Gonzahart/FPV_Simulator_Car/(commit log)

2026-08-13 Add files via upload
    - added cam code
    - added tested servo code
2026-09-05 Add files via upload
    - Initial rear motor + steering motor validated
2026-10-19 Document RC car architecture and motor-control prototype
2026-10-27 Add authenticated web OTA to ESP32-CAM motor test
