Gonzahart/FPV_Simulator_Car/IMG_7815.jpeg

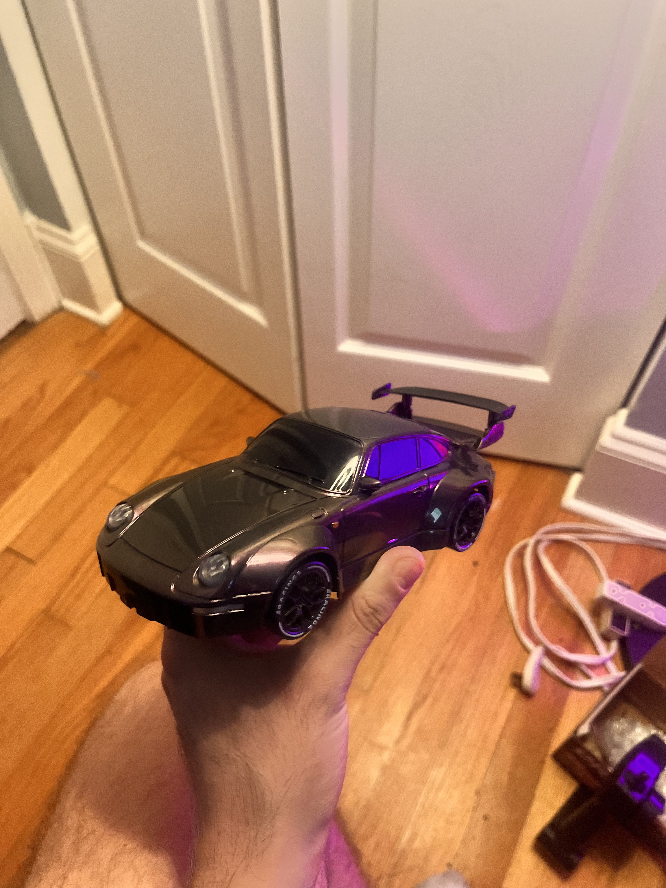
IMG_7815.jpeg
