Gonzahart/FPV_Simulator_Car/IMG_7820.jpeg

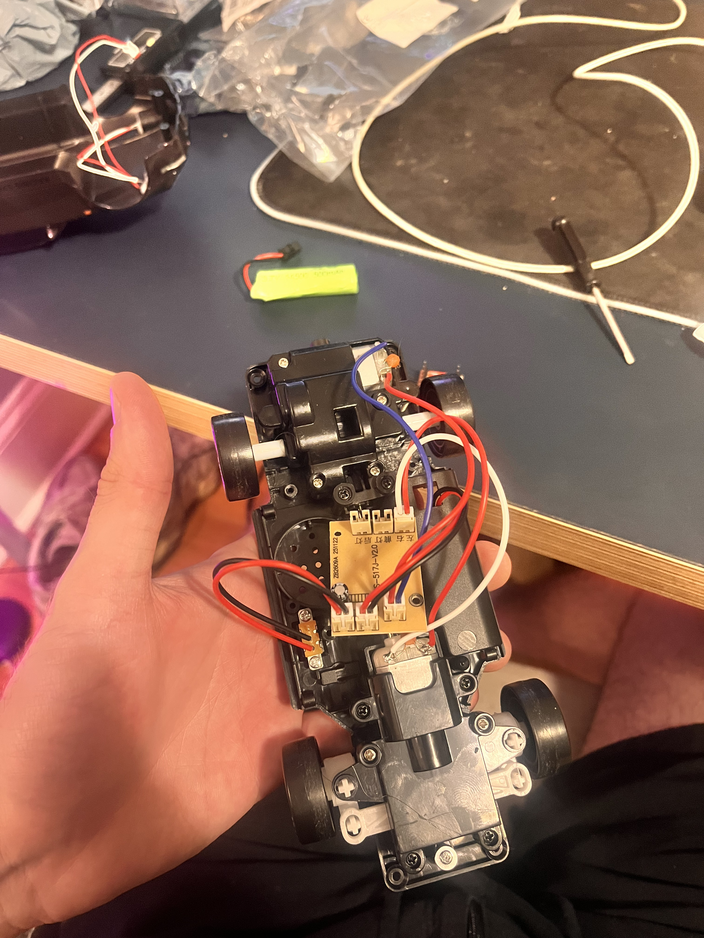
IMG_7820.jpeg
